pengxiang-lu/ch32v203-double-foc/README.assets/e00b897851998023569275c734ad85f7.jpg

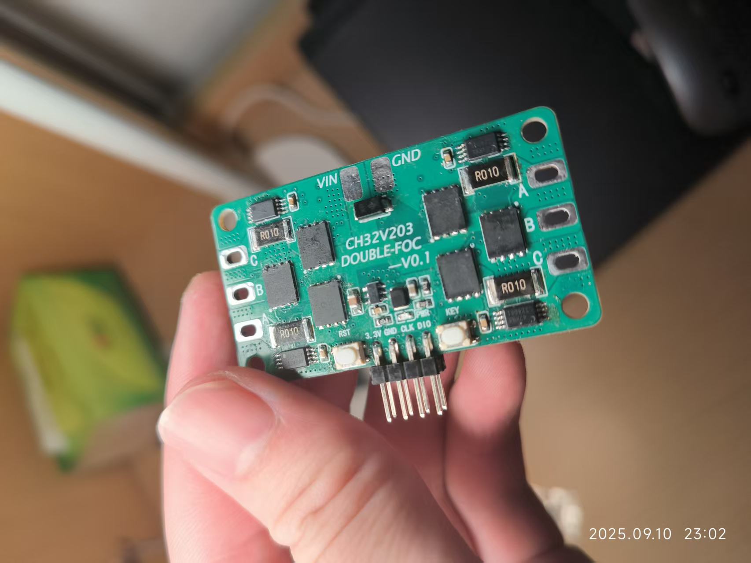
README.assets/e00b897851998023569275c734ad85f7.jpg
