pengxiang-lu/ch32v203-double-foc/(list of files, drawings)

Other design files:
硬件原理图和PCB/CH32V203 DOUBLE-FOC.epro
硬件原理图和PCB/双电机编码器.epro
