pengxiang-lu/ch32v203-double-foc/驱动代码/CH32V203C8T6 FOC双驱/Software/motor_control.c

#include "driver_config.h"		
#include "math.h"
motor_struct left_motor;											// 定义左电机的结构体
motor_struct right_motor;                                           // 定义右电机的结构体
// 空函数
void motor_null()
{

}
//-------------------------------------------------------------------------------------------------------------------
// 函数简介     电机 FLASH 参数 读取
// 参数说明     void
// 返回参数     void
// 使用示例     motor_flash_read();
// 备注信息
//-------------------------------------------------------------------------------------------------------------------
void left_motor_flash_read(void)
{
    // 左电机数据读取
    left_motor.zero_location=FLASH_Read(MOTOR_FLASH_ADDR);
    left_motor.rotation_direction=FLASH_Read(MOTOR_FLASH_ADDR+2);
    left_motor.pole_pairs=FLASH_Read(MOTOR_FLASH_ADDR+4);
}
void right_motor_flash_read(void)
{
    // 右电机数据读取
    right_motor.zero_location=FLASH_Read(MOTOR_FLASH_ADDR+6);
    right_motor.rotation_direction=FLASH_Read(MOTOR_FLASH_ADDR+8);
    right_motor.pole_pairs=FLASH_Read(MOTOR_FLASH_ADDR+10);
}
//-------------------------------------------------------------------------------------------------------------------
// 函数简介     电机 FLASH 参数 写入
// 参数说明     void
// 返回参数     void
// 使用示例     motor_flash_write();
// 备注信息
//-------------------------------------------------------------------------------------------------------------------
void left_motor_flash_write()
{
    // 先读取右电机数据
    uint16_t temp[3];
    temp[0] = FLASH_Read(MOTOR_FLASH_ADDR+6);
    temp[1] = FLASH_Read(MOTOR_FLASH_ADDR+8);
    temp[2] = FLASH_Read(MOTOR_FLASH_ADDR+10);
    // 擦除
    Flash_Erase(MOTOR_FLASH_ADDR);
    // 左电机数据写入
    Flash_WriteHalfWord(MOTOR_FLASH_ADDR,left_motor.zero_location);
    Flash_WriteHalfWord(MOTOR_FLASH_ADDR+2,left_motor.rotation_direction);
    Flash_WriteHalfWord(MOTOR_FLASH_ADDR+4,left_motor.pole_pairs);
    // 右电机数据写入
    Flash_WriteHalfWord(MOTOR_FLASH_ADDR+6,temp[0]);
    Flash_WriteHalfWord(MOTOR_FLASH_ADDR+8,temp[1]);
    Flash_WriteHalfWord(MOTOR_FLASH_ADDR+10,temp[2]);
}
void right_motor_flash_write()
{
    // 先读取左电机数据
    uint16_t temp[3];
    temp[0] = FLASH_Read(MOTOR_FLASH_ADDR);
    temp[1] = FLASH_Read(MOTOR_FLASH_ADDR+2);
    temp[2] = FLASH_Read(MOTOR_FLASH_ADDR+4);
    // 擦除
    Flash_Erase(MOTOR_FLASH_ADDR);
    // 左电机数据写入
    Flash_WriteHalfWord(MOTOR_FLASH_ADDR,temp[0]);
    Flash_WriteHalfWord(MOTOR_FLASH_ADDR+2,temp[1]);
    Flash_WriteHalfWord(MOTOR_FLASH_ADDR+4,temp[2]);
    // 右电机数据写入
    Flash_WriteHalfWord(MOTOR_FLASH_ADDR+6,right_motor.zero_location);
    Flash_WriteHalfWord(MOTOR_FLASH_ADDR+8,right_motor.rotation_direction);
    Flash_WriteHalfWord(MOTOR_FLASH_ADDR+10,right_motor.pole_pairs);
}
// 三相自检，检测MOS和预驱的功能是否正常
void motor_phase_check(motor_struct * motor_p)
{
    uint16_t check_period;
    uint16_t delay_time = 100;
    
    // 第一声  A相上桥 → B相下桥
    check_period = 36000;                       // 2.222khz
    
    motor_p->motor_output_init(check_period);
    
    motor_p->motor_set_duty(check_period / 50, 0, 0);
    
    delay_ms(delay_time);
    
    motor_p->motor_set_duty(0, 0, 0);
    
    delay_ms(50);
    
    // 第二声  B相上桥 → C相下桥
    check_period = 35000;                       // 2.285khz

    motor_p->motor_output_init(check_period);

    motor_p->motor_set_duty(0, check_period / 50, 0);

    delay_ms(delay_time);

    motor_p->motor_set_duty(0, 0, 0);

    delay_ms(50);
    
    // 第三声  C相上桥 → A相下桥
    check_period = 34000;                       // 2.352khz
    
    motor_p->motor_output_init(check_period);
    
    motor_p->motor_set_duty(0, 0, check_period / 50);
    
    delay_ms(delay_time);
    
    motor_p->motor_set_duty(0, 0, 0);
    
	delay_ms(50);

}

void motor_zero_calibration(motor_struct * motor_p)
{        
    int32_t  encoder_data_integral = 0;

#if WATCH_DOG == DRIVER_ENABLE
    watch_dog_calibration_progress();
#endif
    interrupt_global_disable();                 // 关闭所有中断

    if(motor_p->motor_speed_filter != 0)      // 如果电机正在旋转 则刹车
    {
        motor_p->motor_set_duty(0, 0, 0);                                           // 左侧电机刹车
                                        
        delay_ms(1000);                                                             // 刹车等待

#if WATCH_DOG == DRIVER_ENABLE
    watch_dog_calibration_progress();
#endif
    }
    motor_p->encoder_struct.magnetic_encoder_init();                                // 初始化相应的编码器

    motor_phase_check(motor_p);                                                     // 三相 MOS 及 预驱 功能检测 由于没有检测三相电流 因此需要人为判断是否响三声

#if WATCH_DOG == DRIVER_ENABLE
    watch_dog_calibration_progress();
#endif
    
    motor_p->motor_output_init(PWM_PRIOD_LOAD);                                     // 左侧三相 PWM 输出重新初始化
    
    // 矫正零点时默认恢复电机工作保护状态
    motor_p->led_struct.motor_protect_state  = NORMAL_STATE;
    
    // 初始化默认配置参数
    foc_init(&motor_p->foc_cal_struct,1, 0, 1);
    
    // 开环定位 20% 占空比
    foc_calculate(&motor_p->foc_cal_struct, 0,200,0);
    // 输出占空比到电机
    motor_p->motor_set_duty( motor_p->foc_cal_struct.output_duty[0], 
                    motor_p->foc_cal_struct.output_duty[1],
                    motor_p->foc_cal_struct.output_duty[2]);
    
    // 延时 200ms 等待电机回到零点
    delay_ms(1000); 

#if WATCH_DOG == DRIVER_ENABLE
    watch_dog_calibration_progress();
#endif
    // Uq > 0 at electrical angle 0 aligns the rotor to +90 electrical degrees.
    // Keep the raw mechanical reading until direction and pole pairs are known.
    motor_p->zero_location = encoder_get_absolute_data(&motor_p->encoder_struct);

    // 读取当前磁编数据
    encoder_get_absolute_data(&motor_p->encoder_struct);  
    
    // 开环牵引 100 次 
    for(uint16_t i = 0; i <= 100; i ++)                                                                         
    {
        // 以 10% 占空比循环牵引
        foc_calculate(&motor_p->foc_cal_struct,ENCODER_OUTPUT_MAX*i/100,200,0);
        
        // 输出占空比到电机
        motor_p->motor_set_duty( motor_p->foc_cal_struct.output_duty[0], 
                        motor_p->foc_cal_struct.output_duty[1],
                        motor_p->foc_cal_struct.output_duty[2]);
        
        // 单次牵引间隔为（默认5ms） 
        delay_ms(5);  

        encoder_get_absolute_data(&motor_p->encoder_struct);// 获取当前磁编码器数值
        // Accumulate signed displacement; its sign determines sensor direction.
        encoder_data_integral += motor_p->encoder_struct.encoder_value_offset;

#if WATCH_DOG == DRIVER_ENABLE
    watch_dog_calibration_progress();
#endif
    }                                                               
       
    
    // 关闭输出
    motor_p->motor_set_duty(0, 0, 0);                                                        
    // 判断是否正确读取到磁编数据 开环牵引积分小于 1000 则认为电机没有旋转   折算下来为11°意味着超过 32 对极的电机无法检测
    if(func_abs(encoder_data_integral) < 1000)
    {
        // 更改磁编码器状态标志
        motor_p->led_struct.encoder_state = ERROR_STATE;

        // 修正默认参数
        motor_p->zero_location = 0;
        motor_p->rotation_direction = -1;
        motor_p->pole_pairs = 7;

        // 错误信息打印到 串口
        printf("%s magnetic encoder error!!\r\n",motor_p->motor_name);

    }
    else
    {
        // 更改磁编码器状态标志
        motor_p->led_struct.encoder_state = NORMAL_STATE;
        
        // 旋转方向归一化 正转则为 1  反转则为 -1
        motor_p->rotation_direction = encoder_data_integral > 0 ? 1 : -1;
        
        // 计算极对数  磁编最大值 除以 单圈电角度积分值 四舍五入
        motor_p->pole_pairs = (int16_t)((ENCODER_OUTPUT_MAX
            + func_abs(encoder_data_integral) / 2) / func_abs(encoder_data_integral));

        // Subtract 90 ELECTRICAL degrees after the mechanical-to-electrical conversion.
        motor_p->zero_location = normalize(
            (int32_t)motor_p->rotation_direction * motor_p->pole_pairs
            * motor_p->zero_location - ENCODER_PRECISION / 4);
        // 按照计算的数据重新初始化fast_foc参数
        foc_init(&motor_p->foc_cal_struct,motor_p->pole_pairs, motor_p->zero_location, motor_p->rotation_direction);
        // 成功初始化电机指示
        printf("%s init successfully\r\n",motor_p->motor_name);
        // 矫正信息打印到 串口
        printf("motor zero:%d, dir:%s, pole pairs:%d\r\n", motor_p->foc_cal_struct.motor_zero_location, 
                                                          motor_p->foc_cal_struct.motor_rotation_direction == 1 ? "forward" : "reverse",
                                                          motor_p->pole_pairs);
        motor_p->write_flash();

    }
    delay_ms(1000);

#if WATCH_DOG == DRIVER_ENABLE
    watch_dog_calibration_progress();
#endif
    interrupt_global_enable();              //开启所有中断
}
//-------------------------------------------------------------------------------------------------------------------
// 函数简介     电机FOC控制初始化
// 参数说明     void
// 返回参数     void
// 使用示例     motor_foc_control_init();
// 备注信息       
//-------------------------------------------------------------------------------------------------------------------
void motor_foc_control_init(motor_struct * motor_p)
{
    motor_p->led_struct.motor_protect_state  = NORMAL_STATE;          	    // 初始化默认电机为正常工作模式
  
    motor_p->led_struct.encoder_state        = NORMAL_STATE;           	// 初始化默认磁编码器为正常工作模式
    
    motor_p->encoder_struct.magnetic_encoder_init();            // 磁编码器初始化

    # if FIRST_USE == YES                                       // 如果是第一次使用，此时flash里面没有数据，读取会出bug
    // 这时候给默认参数
    motor_p->pole_pairs = 7;
    motor_p->zero_location = 0;
    motor_p->rotation_direction = 1;
    motor_p->write_flash();
    #else
    motor_p->read_flash();
    #endif
    foc_init(&motor_p->foc_cal_struct,motor_p->pole_pairs, motor_p->zero_location, motor_p->rotation_direction);     // 电机 FAST_FOC 功能初始化
    
    motor_p->motor_output_init(PWM_PRIOD_LOAD);     			// 电机三相 PWM 输出初始化

	#if	CURRENT_SENSOR == DRIVER_ENABLE							// 带电流环则需要相应的初始化
	
    if (!inline_currentsense_init(&motor_p->current_struct))
    {
        motor_p->led_struct.motor_protect_state = ERROR_STATE;
        motor_p->motor_set_duty(0, 0, 0);
    }

	#endif
	
	motor_p->motor_angle = motor_p->rotation_direction * encoder_get_absolute_data(&motor_p->encoder_struct);
}
#define VECOCITY_OB_COUNT			(F_OPEN / F_VECOCITY_OB)
#define VECOCITY_LOOP_COUNT			(F_OPEN / F_VECOCITY)
#define ANGLE_LOOP_COUNT			(F_OPEN / F_ANGLE)
#define SPEED_Q16_NUMERATOR (60LL * F_OPEN * 65536LL)
#define SPEED_Q16_DENOMINATOR (1LL * ENCODER_PRECISION * VECOCITY_OB_COUNT)
#if VECOCITY_OB_COUNT < 1
#error "Speed observation interval must be at least one control cycle"
#endif

static void motor_update_current_loop(motor_struct * motor_p)
{
#if CURRENT_SENSOR == DRIVER_ENABLE
    inline_current_get_current(&motor_p->current_struct);
    current_duty_calculate(&motor_p->foc_cal_struct,
                          &motor_p->current_struct);

    motor_p->current_struct.i_q_filter = (motor_p->current_struct.i_q_filter * 9 + motor_p->current_struct.i_q) / 10;
    motor_p->current_struct.i_d_filter = (motor_p->current_struct.i_d_filter * 9 + motor_p->current_struct.i_d) / 10;

#ifdef FOC_MODE_WITH_CURRENT
#if FOC_MODE != I_D_LOOP_MODE
    motor_p->u_q_duty = pi_controller(&motor_p->i_q_pid_struct,
                                     motor_p->i_q_set - motor_p->current_struct.i_q_filter);
#endif
    motor_p->u_d_duty = pi_controller(&motor_p->i_d_pid_struct,
                                     motor_p->i_d_set - motor_p->current_struct.i_d_filter);
#endif
#endif
}

static void motor_update_speed_observe(motor_struct * motor_p)
{
    if(++motor_p->speed_observe_count < VECOCITY_OB_COUNT)
    {
        return;
    }

    motor_p->speed_observe_count = 0;
    // 位置和速度使用相同的机械方向定义。
    int32_t angle_delta = motor_p->rotation_direction
                        * motor_p->encoder_struct.encoder_offset_integral;
    // 使用实际整数分频后的观测周期，即 20000/3，而不是标称的 6000Hz。
    // 低速附近在低通滤波内部保留 RPM 小数。
#if (SPEED_Q16_NUMERATOR % SPEED_Q16_DENOMINATOR) == 0
    // 当前配置系数精确等于1600000，编译期约分后只执行乘法。
    int64_t speed_q16 = (int64_t)angle_delta
                      * (SPEED_Q16_NUMERATOR / SPEED_Q16_DENOMINATOR);
#else
    // 修改频率后若不能整除，保持原公式的精度和向零取整行为。
    int64_t speed_q16 = (int64_t)angle_delta * SPEED_Q16_NUMERATOR
                      / SPEED_Q16_DENOMINATOR;
#endif
    motor_p->motor_speed = (int32_t)(speed_q16 / 65536);
    motor_p->motor_speed_filter_q16 =(motor_p->motor_speed_filter_q16 * 19 + speed_q16) / 20;
    motor_p->motor_speed_filter = (int32_t)(motor_p->motor_speed_filter_q16 / 65536);
    motor_p->motor_angle += angle_delta;
    motor_p->encoder_struct.encoder_offset_integral = 0;
}

static void motor_update_angle_loop(motor_struct * motor_p)
{
    if(++motor_p->angle_count < ANGLE_LOOP_COUNT)
    {
        return;
    }

    motor_p->angle_count = 0;

    if(FOC_MODE == ANGLE_LOOP_MODE)
    {
        motor_p->u_q_duty = p_controller(&motor_p->angle_pid_struct,motor_p->motor_angle_set - motor_p->motor_angle);
    }
    else if(FOC_MODE == ANGLE_VECOCITY_LOOP_MODE)
    {
        motor_p->motor_speed_set = p_controller(&motor_p->angle_pid_struct,motor_p->motor_angle_set - motor_p->motor_angle);
    }
    else if(FOC_MODE == ANGLE_CURRENT_LOOP_MODE && CURRENT_SENSOR == DRIVER_ENABLE)
    {
        motor_p->i_q_set = pd_controller(&motor_p->angle_pid_struct,
                                        motor_p->motor_angle_set - motor_p->motor_angle,
                                        motor_p->motor_speed_filter);
    }
    else if(FOC_MODE == ANGLE_VECOCITY_CURRENT_LOOP_MODE && CURRENT_SENSOR == DRIVER_ENABLE)
    {
        motor_p->motor_speed_set = p_controller(&motor_p->angle_pid_struct,
                                               motor_p->motor_angle_set - motor_p->motor_angle);
    }
}

static void motor_update_speed_loop(motor_struct * motor_p)
{
    if(++motor_p->speed_count < VECOCITY_LOOP_COUNT)
    {
        return;
    }

    motor_p->speed_count = 0;

#if MOTOR_LOCKED_PROTECT == DRIVER_ENABLE
    if(func_abs(motor_p->motor_speed_filter) < 10 && func_abs(motor_p->u_q_duty) >= MOTOR_LOCKED_DUTY_MAX)
    {
        motor_p->protect_count ++;

        if(motor_p->protect_count > MOTOR_LOCKED_TIME)
        {
            motor_p->protect_count = MOTOR_LOCKED_TIME;
            motor_p->led_struct.motor_protect_state = ERROR_STATE;
        }
    }
    else
    {
        motor_p->protect_count = 0;
    }
#endif

    if(FOC_MODE == VECOCITY_LOOP_MODE || FOC_MODE == ANGLE_VECOCITY_LOOP_MODE)
    {
        motor_p->u_q_duty = pi_controller(&motor_p->vecocity_pid_struct,
                                         motor_p->motor_speed_set - motor_p->motor_speed_filter);
    }
    else if(FOC_MODE == VECOCITY_CURRENT_LOOP_MODE && CURRENT_SENSOR == DRIVER_ENABLE)
    {
        motor_p->i_q_set = pi_controller(&motor_p->vecocity_pid_struct,
                                        motor_p->motor_speed_set - motor_p->motor_speed_filter);
    }
    else if(FOC_MODE == ANGLE_VECOCITY_CURRENT_LOOP_MODE && CURRENT_SENSOR == DRIVER_ENABLE)
    {
        motor_p->i_q_set = pi_controller(&motor_p->vecocity_pid_struct,
                                        motor_p->motor_speed_set - motor_p->motor_speed_filter);
    }
}

// 电机执行回调函数 50ms进一次
void motor_callback(motor_struct * motor_p)
{
    encoder_get_absolute_data(&motor_p->encoder_struct);
    motor_p->encoder_struct.encoder_offset_integral += motor_p->encoder_struct.encoder_value_offset;

    // 每个电机每周期只换算一次电角度，电流变换和电压调制共用。
    foc_update_electrical_angle(&motor_p->foc_cal_struct,
                                motor_p->encoder_struct.encoder_value_now);

    // 1. 电流环：采样、dq变换、滤波和 PI 控制
    motor_update_current_loop(motor_p);

    // 2. 速度观测：更新速度和角度积分，按低频节拍执行
    motor_update_speed_observe(motor_p);

    // 3. 角度环 / 速度外环：只在低频节拍更新 setpoint
    motor_update_angle_loop(motor_p);

    // 4. 速度环：在较低频节拍更新速度闭环或内环参考值
    motor_update_speed_loop(motor_p);

    // 5. FOC计算与输出
    foc_calculate_with_angle(&motor_p->foc_cal_struct,
                             motor_p->u_q_duty,
                             motor_p->u_d_duty);

    if(motor_p->led_struct.motor_protect_state == ERROR_STATE
       || motor_p->led_struct.encoder_state == ERROR_STATE
       || battery_struct.battery_state == ERROR_STATE)
    {
        motor_p->motor_set_duty(0, 0, 0);
    }
    else
    {
        motor_p->motor_set_duty(motor_p->foc_cal_struct.output_duty[0],
                                motor_p->foc_cal_struct.output_duty[1],
                                motor_p->foc_cal_struct.output_duty[2]);
    }
}

static inline int32_t motor_cycles_to_us(uint32_t cycles)
{
    uint32_t cycles_per_us = SystemCoreClock / 1000000U;

    if (cycles_per_us == 0U)
    {
        return 0;
    }

    // 四舍五入为整数微秒，避免使用耗时更长的64位除法。
    return (int32_t)((cycles + cycles_per_us / 2U) / cycles_per_us);
}

void TIM1_UP_IRQHandler(void) __attribute__((interrupt("WCH-Interrupt-fast")));
// 定时器1中断服务函数
void TIM1_UP_IRQHandler(void)
{
    uint32_t start_cycles = system_tick_get();

    if (TIM_GetITStatus(TIM1, TIM_IT_Update) != RESET)
    {
        TIM_ClearITPendingBit(TIM1, TIM_IT_Update);
        uint8_t frame_ready = adc_sample_publish();
        adc_sample_start(); // 每个控制周期统一启动一次扫描，此处不阻塞等待。
#ifdef FOC_MODE_WITH_CURRENT
        if (!frame_ready)
        {
            // 数据帧不完整或已过期时，不运行电流 PI。
#if LEFT_MOTOR_STATE == DRIVER_ENABLE
            left_motor.motor_set_duty(0, 0, 0);
#endif
#if RIGHT_MOTOR_STATE == DRIVER_ENABLE
            right_motor.motor_set_duty(0, 0, 0);
#endif
            goto calculation_finished;
        }
#else
        (void)frame_ready;
#endif
#if LEFT_MOTOR_STATE == DRIVER_ENABLE
        motor_callback(&left_motor);
#endif
#if RIGHT_MOTOR_STATE == DRIVER_ENABLE
        motor_callback(&right_motor);
#endif
#if WATCH_DOG == DRIVER_ENABLE
        watch_dog_control_progress();
#endif
    }

#ifdef FOC_MODE_WITH_CURRENT
calculation_finished:
#endif
    {
        uint32_t used_cycles = system_tick_get() - start_cycles;
        int32_t used_time_us = motor_cycles_to_us(used_cycles);

#if LEFT_MOTOR_STATE == DRIVER_ENABLE
        left_motor.single_calculation_use_time = used_time_us;
#endif
#if RIGHT_MOTOR_STATE == DRIVER_ENABLE
        right_motor.single_calculation_use_time = used_time_us;
#endif
        (void)used_time_us;
    }
}
