pengxiang-lu/ch32v203-double-foc/驱动代码/CH32V203C8T6 FOC双驱/Software/foc.c

#include "foc.h"
#include "driver_config.h"
const int16_t foc_output_array[FOC_ARRAY_LENGTH]={
0,1,3,4,6,7,9,10,12,13,15,16,18,19,21,23,24,26,27,29,30,
32,33,35,36,38,39,41,42,44,46,47,49,50,52,53,55,56,58,59,61,
62,64,65,67,68,70,72,73,75,76,78,79,81,82,84,85,87,88,90,91,
93,94,96,98,99,101,102,104,105,107,108,110,111,113,114,116,117,119,120,122,
123,125,126,128,130,131,133,134,136,137,139,140,142,143,145,146,148,149,151,152,
154,155,157,158,160,161,163,164,166,167,169,170,172,173,175,177,178,180,181,183,
184,186,187,189,190,192,193,195,196,198,199,201,202,204,205,207,208,210,211,213,
214,216,217,219,220,222,223,225,226,228,229,231,232,234,235,237,238,240,241,242,
244,245,247,248,250,251,253,254,256,257,259,260,262,263,265,266,268,269,271,272,
274,275,277,278,279,281,282,284,285,287,288,290,291,293,294,296,297,299,300,302,
303,304,306,307,309,310,312,313,315,316,318,319,320,322,323,325,326,328,329,331,
332,333,335,336,338,339,341,342,344,345,346,348,349,351,352,354,355,357,358,359,
361,362,364,365,367,368,369,371,372,374,375,377,378,379,381,382,384,385,386,388,
389,391,392,393,395,396,398,399,401,402,403,405,406,408,409,410,412,413,415,416,
417,419,420,422,423,424,426,427,428,430,431,433,434,435,437,438,439,441,442,444,
445,446,448,449,450,452,453,455,456,457,459,460,461,463,464,465,467,468,470,471,
472,474,475,476,478,479,480,482,483,484,486,487,488,490,491,492,494,495,496,498,
499,500,502,503,504,506,507,508,510,511,512,514,515,516,518,519,520,521,523,524,
525,527,528,529,531,532,533,534,536,537,538,540,541,542,544,545,546,547,549,550,
551,553,554,555,556,558,559,560,561,563,564,565,566,568,569,570,572,573,574,575,
577,578,579,580,582,583,584,585,587,588,589,590,591,593,594,595,596,598,599,600,
601,603,604,605,606,607,609,610,611,612,614,615,616,617,618,620,621,622,623,624,
626,627,628,629,630,632,633,634,635,636,637,639,640,641,642,643,645,646,647,648,
649,650,652,653,654,655,656,657,658,660,661,662,663,664,665,666,668,669,670,671,
672,673,674,676,677,678,679,680,681,682,683,685,686,687,688,689,690,691,692,693,
695,696,697,698,699,700,701,702,703,704,706,707,708,709,710,711,712,713,714,715,
716,717,718,720,721,722,723,724,725,726,727,728,729,730,731,732,733,734,735,736,
737,738,739,740,741,743,744,745,746,747,748,749,750,751,752,753,754,755,756,757,
758,759,760,761,762,763,764,765,766,767,768,769,770,771,772,773,773,774,775,776,
777,778,779,780,781,782,783,784,785,786,787,788,789,790,791,792,793,793,794,795,
796,797,798,799,800,801,802,803,804,805,805,806,807,808,809,810,811,812,813,814,
814,815,816,817,818,819,820,821,821,822,823,824,825,826,827,828,828,829,830,831,
832,833,834,834,835,836,837,838,839,839,840,841,842,843,844,844,845,846,847,848,
848,849,850,851,852,852,853,854,855,856,856,857,858,859,860,860,861,862,863,863,
864,865,866,867,867,868,869,870,870,871,872,873,873,874,875,876,876,877,878,879,
879,880,881,881,882,883,884,884,885,886,886,887,888,889,889,890,891,891,892,893,
893,894,895,895,896,897,898,898,899,900,900,901,902,902,903,903,904,905,905,906,
907,907,908,909,909,910,911,911,912,912,913,914,914,915,916,916,917,917,918,919,
919,920,920,921,922,922,923,923,924,925,925,926,926,927,927,928,929,929,930,930,
931,931,932,932,933,934,934,935,935,936,936,937,937,938,938,939,939,940,941,941,
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
int32_t fast_sin(int32_t x) 
{
	// 归一化
	while(x>ENCODER_OUTPUT_MAX)
	{
		x-=ENCODER_PRECISION;
	}
	while(x<0)
	{
		x+=ENCODER_PRECISION;
	}
	return foc_output_array[x * ENCODER_TO_ARRAY_RATIO];
}
int32_t fast_cos(int32_t x) 
{
	x=x+ENCODER_PRECISION_4;
	// 归一化
	while(x>ENCODER_OUTPUT_MAX)
	{
		x-=ENCODER_PRECISION;
	}
	while(x<0)
	{
		x+=ENCODER_PRECISION;
	}
	return foc_output_array[x * ENCODER_TO_ARRAY_RATIO];
}
//归一化函数
int32_t normalize(int32_t location_temp)
{
	// 归一化
	while(location_temp>ENCODER_OUTPUT_MAX)
	{
		location_temp -= ENCODER_PRECISION;
	}
	while(location_temp<0)
	{
		location_temp += ENCODER_PRECISION;
	}
	return location_temp;
}
static uint32_t integer_sqrt(uint64_t n)
{
    // 二进制整数开方，结果向下取整；不使用除法，避免中间结果溢出。
    uint64_t root = 0;
    uint64_t bit = (uint64_t)1 << 62;
    while (bit > n)
        bit >>= 2;

    while (bit != 0)
    {
        if (n >= root + bit)
        {
            n -= root + bit;
            root = (root >> 1) + bit;
        }
        else
        {
            root >>= 1;
        }
        bit >>= 2;
    }
    return (uint32_t)root;
}
void circle_limitation(foc_struct *foc_p,int32_t u_q_duty,int32_t u_d_duty)
{
    // 单轴平方可用有符号64位整数保存，两轴平方和使用无符号64位整数。
    uint64_t magnitude_squared = (uint64_t)((int64_t)u_q_duty * u_q_duty)
                               + (uint64_t)((int64_t)u_d_duty * u_d_duty);
    int64_t limit = MOTOR_DUTY_MAX;
    if (magnitude_squared <= (uint64_t)(limit * limit))
    {
        foc_p->u_q = u_q_duty;
        foc_p->u_d = u_d_duty;
        return;
    }

    // 矢量幅值向上取整，确保缩放后的矢量不超过圆限幅边界。
    int64_t magnitude = integer_sqrt(magnitude_squared);
    if ((uint64_t)(magnitude * magnitude) < magnitude_squared)
        ++magnitude;

    // 使用有符号64位除法，保留两个轴的电压方向。
    foc_p->u_q = (int32_t)(limit * u_q_duty / magnitude);
    foc_p->u_d = (int32_t)(limit * u_d_duty / magnitude);
}
uint8_t svpwm_transform_table[8] ={0,2,6,1,4,3,5,7};						// N编号转化为真实的扇区编号
// 更新电角度，供本周期的电流变换和电压调制共用。
void foc_update_electrical_angle(foc_struct *foc_p, int32_t now_encoder_data)
{
	// 计算电角度
	foc_p->encoder_el = foc_p->motor_rotation_direction*foc_p->motor_pole_pairs*now_encoder_data-foc_p->motor_zero_location;
	// 归一化
	foc_p->encoder_el = normalize(foc_p->encoder_el);
}

// 保留原接口，供启动校准等独立调用使用。
void foc_calculate(foc_struct *foc_p, int32_t now_encoder_data, int32_t u_q_duty,int32_t u_d_duty)
{
    foc_update_electrical_angle(foc_p, now_encoder_data);
    foc_calculate_with_angle(foc_p, u_q_duty, u_d_duty);
}

// 使用已更新的电角度，本函数不再读取或换算编码器角度。
void foc_calculate_with_angle(foc_struct *foc_p, int32_t u_q_duty, int32_t u_d_duty)
{
	// u_q,u_d合成矢量圆限幅
	circle_limitation(foc_p,u_q_duty,u_d_duty);	
	// 定义三相输出位置临时变量
	static int32_t location_temp_a = 0;                                                 
    static int32_t location_temp_b = 0;
    static int32_t location_temp_c = 0;
	// 三相角度计算
	location_temp_a = foc_p->encoder_el + ENCODER_PRECISION_2;
	location_temp_b = foc_p->encoder_el + ENCODER_PRECISION_6;
	location_temp_c = foc_p->encoder_el - ENCODER_PRECISION_6;
	// 归一化
	location_temp_a = normalize(location_temp_a);
	location_temp_b = normalize(location_temp_b);
	location_temp_c = normalize(location_temp_c);	
	#if	PWM_MODE == SPWM					// SPWM调制方式
	// 三相占空比计算，三角自带归一化
	foc_p->u_a = ((foc_p->u_q * fast_sin(location_temp_a) - foc_p->u_d * fast_cos(location_temp_a))>>MOTOR_DUTY_BIT) * ARRAY_TO_OUTPUT_RATIO;
	foc_p->u_b = ((foc_p->u_q * fast_sin(location_temp_b) - foc_p->u_d * fast_cos(location_temp_b))>>MOTOR_DUTY_BIT) * ARRAY_TO_OUTPUT_RATIO;
    foc_p->u_c = ((foc_p->u_q * fast_sin(location_temp_c) - foc_p->u_d * fast_cos(location_temp_c))>>MOTOR_DUTY_BIT) * ARRAY_TO_OUTPUT_RATIO;
	// 输出计算
	foc_p->output_duty[0] = (foc_p->u_a + FOC_MIDDLE_DUTY);
	foc_p->output_duty[1] = (foc_p->u_b + FOC_MIDDLE_DUTY);
	foc_p->output_duty[2] = (foc_p->u_c + FOC_MIDDLE_DUTY);
		
	#elif PWM_MODE == SVPWM_7 || PWM_MODE == SVPWM_5		// 采用SVPWM调制
	// 三个参考电压的计算
	foc_p->u_1 = (-(foc_p->u_q * fast_cos(location_temp_a) + foc_p->u_d * fast_sin(location_temp_a))>>MOTOR_DUTY_BIT) * ARRAY_TO_OUTPUT_RATIO;
	foc_p->u_2 = (-(foc_p->u_q * fast_cos(location_temp_c) + foc_p->u_d * fast_sin(location_temp_c))>>MOTOR_DUTY_BIT) * ARRAY_TO_OUTPUT_RATIO;
	foc_p->u_3 = (-(foc_p->u_q * fast_cos(location_temp_b) + foc_p->u_d * fast_sin(location_temp_b))>>MOTOR_DUTY_BIT) * ARRAY_TO_OUTPUT_RATIO;
	
	foc_p->svpwm.sector_num = svpwm_transform_table[(foc_p->u_1>0?1:0) + 2 * (foc_p->u_2>0?1:0) + 4 * (foc_p->u_3>0?1:0)];		// 查表获取具体扇区编号
	
	switch(foc_p->svpwm.sector_num)
	{
		case 1:
			foc_p->svpwm.tx = foc_p->u_2 * SVPWM_K;		// t4
			foc_p->svpwm.ty = foc_p->u_1 * SVPWM_K;		// t6
			break;	
		
		case 2:
			foc_p->svpwm.tx = -foc_p->u_2 * SVPWM_K;	// t2
			foc_p->svpwm.ty = -foc_p->u_3 * SVPWM_K;	// t6
			break;	
		
		case 3:
			foc_p->svpwm.tx = foc_p->u_1 * SVPWM_K;		// t2
			foc_p->svpwm.ty	= foc_p->u_3 * SVPWM_K;		// t3
			break;	
		
		case 4:
			foc_p->svpwm.tx = -foc_p->u_1 * SVPWM_K;	// t1
			foc_p->svpwm.ty = -foc_p->u_2 * SVPWM_K;	// t3
			break;	
		
		case 5:
			foc_p->svpwm.tx = foc_p->u_3 * SVPWM_K;		// t1
			foc_p->svpwm.ty = foc_p->u_2 * SVPWM_K;		// t5
			break;	
			
		case 6:
			foc_p->svpwm.tx = -foc_p->u_3 * SVPWM_K;	// t4
			foc_p->svpwm.ty	= -foc_p->u_1 * SVPWM_K;	// t5
			break;
		
		default:
			foc_p->svpwm.tx = 0;
			foc_p->svpwm.ty = 0;
			break;
	}
	// 防止过调制
	static uint32_t t_sum = 0;
	t_sum = foc_p->svpwm.tx+foc_p->svpwm.ty;
	if(t_sum > foc_p->svpwm.ts)					// 如果有效矢量作用时间之和大于周期
	{
		foc_p->svpwm.tx = foc_p->svpwm.ts*foc_p->svpwm.tx/t_sum;
		foc_p->svpwm.ty = foc_p->svpwm.ts*foc_p->svpwm.ty/t_sum;
	}
	#if	PWM_MODE == SVPWM_5			// 如果是5段式SVPWM调制
	// PWM1模式下的调制
	foc_p->svpwm.ta = foc_p->svpwm.ts>>1;							// 就是满占空比
	foc_p->svpwm.tb = foc_p->svpwm.ta - (foc_p->svpwm.tx>>1); 
	foc_p->svpwm.tc = foc_p->svpwm.tb - (foc_p->svpwm.ty>>1); 
	#elif PWM_MODE == SVPWM_7		// 如果是7段式SVPWM调制
	foc_p->svpwm.ta = (foc_p->svpwm.ts + foc_p->svpwm.tx + foc_p->svpwm.ty)>>2;		
	foc_p->svpwm.tb = foc_p->svpwm.ta - (foc_p->svpwm.tx>>1); 
	foc_p->svpwm.tc = foc_p->svpwm.tb - (foc_p->svpwm.ty>>1); 
	#endif
	switch(foc_p->svpwm.sector_num)
	{
		case 1:
		foc_p->output_duty[0] = foc_p->svpwm.ta;		
		foc_p->output_duty[1] = foc_p->svpwm.tb;
		foc_p->output_duty[2] = foc_p->svpwm.tc;
		break;
		case 2:
		foc_p->output_duty[0] = foc_p->svpwm.tb;		
		foc_p->output_duty[1] = foc_p->svpwm.ta;
		foc_p->output_duty[2] = foc_p->svpwm.tc;
		break;
		case 3:
		foc_p->output_duty[0] = foc_p->svpwm.tc;		
		foc_p->output_duty[1] = foc_p->svpwm.ta;
		foc_p->output_duty[2] = foc_p->svpwm.tb;
		break;
		case 4:
		foc_p->output_duty[0] = foc_p->svpwm.tc;		
		foc_p->output_duty[1] = foc_p->svpwm.tb;
		foc_p->output_duty[2] = foc_p->svpwm.ta;
		break;
		case 5:
		foc_p->output_duty[0] = foc_p->svpwm.tb;		
		foc_p->output_duty[1] = foc_p->svpwm.tc;
		foc_p->output_duty[2] = foc_p->svpwm.ta;
		break;
		case 6:
		foc_p->output_duty[0] = foc_p->svpwm.ta;		
		foc_p->output_duty[1] = foc_p->svpwm.tc;
		foc_p->output_duty[2] = foc_p->svpwm.tb;
		break;
        default:
        // 零矢量或量化为零时，三相保持相同的共模电平。
        foc_p->output_duty[0] = foc_p->svpwm.ta;
        foc_p->output_duty[1] = foc_p->svpwm.ta;
        foc_p->output_duty[2] = foc_p->svpwm.ta;
        break;
	}
	
	#endif
	
}
void foc_init(foc_struct *foc_p,uint32_t motor_pole_pairs, int32_t zero_location, int32_t rotation_direction)
{	
    foc_p->motor_pole_pairs         = motor_pole_pairs;             // 保存当前电机的极对数
    
    foc_p->motor_zero_location      = zero_location;                // 保存当前电机的零点位置
    
    foc_p->motor_rotation_direction = rotation_direction;           // 保存当前电机的旋转方向
	
	foc_p->svpwm.ts 				= OUTPUT_DUTY_MAX * 2;		    // 计算总周期
}
