pengxiang-lu/ch32v203-double-foc/驱动代码/CH32V203C8T6 FOC双驱/Hardware/driver_adc.h

#ifndef __DRIVER_ADC_H_
#define __DRIVER_ADC_H_
#include <stdint.h>
void current_sensor_adc_init(void);
// 非阻塞帧服务；使用者只能读取已发布的采样快照。
void adc_sample_start(void);
uint8_t adc_sample_publish(void);
void battery_adc_init(void);
uint16_t battery_adc_read(void);
void left_inline_current_read_adc(void);
void right_inline_current_read_adc(void);
#endif
