pengxiang-lu/ch32v203-double-foc/(commit log)

2026-10-07 初始化仓库
    [CH32V203 DOUBLE-FOC.epro]
2026-10-07 修复双电机驱动配置
2026-10-07 全部初始上传
2026-10-08 添加了README
2026-10-08 修改了pid.c的bug
2026-10-10 小改一下
2026-10-10 解决了电流采样初始化不对称的问题
2026-10-10 神奇，计算电机速度的时候不需要乘以motor_p->rotation_direction
2026-10-10 板子坏了，等我修好再回来
2026-10-11 修改了代码中的电池电压监测代码
2026-10-11 AI小改代码，改了回调函数的控制逻辑
2026-10-12 AI辅助修改
2026-10-12 吴迪AI
2026-10-12 基本结束了，除了电流角度环有震动之外，感觉原因是电流环丝滑了，阻尼小导致震荡
2026-10-12 修改了说明文档
2026-10-12 修改了一些比较小的bug，把角度电流环外环改为pd控制
2026-10-12 电流+角度环调参完毕，电流+速度+角度环调参完毕，可以正常使用
2026-10-12 修改完善了README文档，然后新增了编码器架子的PCB文件
2026-10-12 使用systick来计一个执行周期的时间(修改了delay函数的逻辑)
2026-10-12 优化了代码执行效率：速度观测：先精确化简常数，去掉一次 64 位除法；每个电机每次只计算一次电角度。 对电池电压测量加入了低通滤波。 至此该项目基本告一段落。
2026-10-13 去掉了测量电压的均值滤波，只保留低通滤波
2026-10-14 配置电机运动反馈方向并统一位置与速度反馈
    增加左右电机独立反馈方向配置，用于启动角度和运动观测；保留当前速度环调试配置，启用电流采样与速度回传。反馈方向为临时补偿，电角度零点及转矩方向的根因仍待硬件排查。MounRiver 工具链完整编译通过。
2026-10-14 修正电角度零点校准并移除反馈方向补偿
    在机械角度转换为电角度之后补偿90度，修正极对数整数四舍五入，并根据累计位移判断方向。位置和速度统一使用rotation_direction。增加FOC数值诊断脚本，保留当前速度电流双环配置。
    完整编译及数值检查通过。升级后必须重新校准Flash零点；当前仍会自动进入闭环，尚未实现校准前禁止输出的启动流程。
2026-10-14 完善了看门狗🐶代码
2026-10-16 优化串口响应速度，给最高优先级
2026-10-16 上传演示视频，到此终结
